Rennaafi/espeak-hub/bench/figures/fig4_latency_breakdown.pdf

0.0 | 0.5 | 1.0 | 1.5 | 2.0 | 2.5 | 3.0 | 3.5
Time from end of speech to first sound (s)

V1 (P = 250 ms)

V0

1.87 s

3.03 s

STT | LLM | TTS | device: download + start
