Rennaafi/espeak-hub/docs/images/UI 2.jpeg

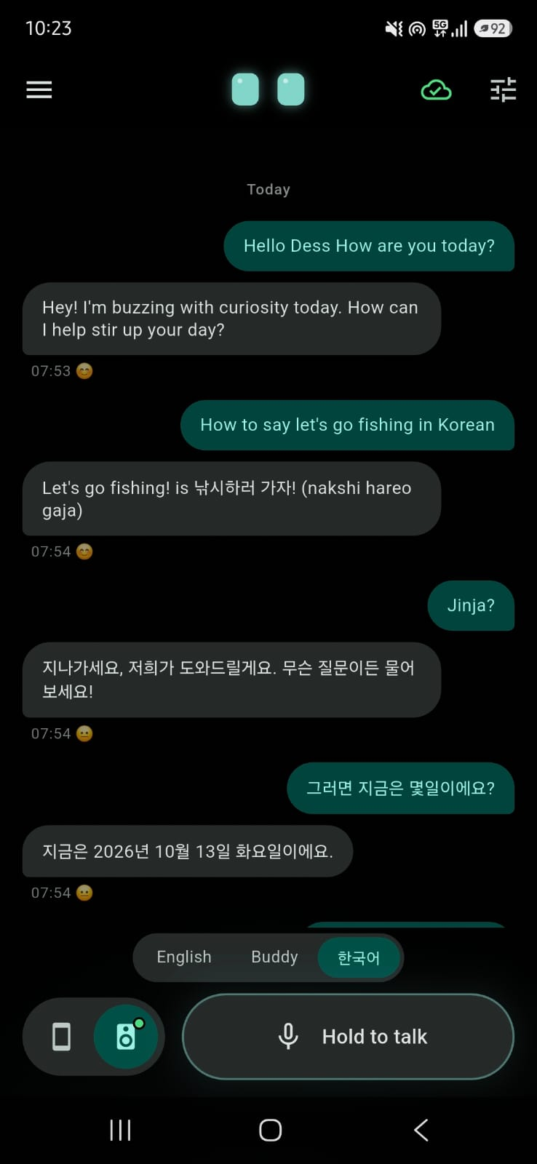
docs/images/UI 2.jpeg
