Rennaafi/espeak-hub/bench/results/summary.csv

variant | prebuf_ms | clip | n | ttfs_median | ttfs_iqr | ttfs_p95 | ttfs_max | dl_median | throughput_kBps | starves | runs_with_starve | max_gap_ms | dry | load0_median | load1_median | pload0_median | pload1_median | face_fps | face_max_gap_ms | hwm_audio_min | hwm_face_min | hwm_loop_min | hwm_i2s_min | heap_min | rssi_median
V0 |  | long | 20 | 4402.85 | 170.64 | 6357.45 | 8625.46 | 4373.33 | 146.63 | 0 | 0 | 0.00 | 0 | 10.90 | 81.10 | 6.80 | 100.00 | 20.03 | 63.26 | 1788 | 6288 | 3852 | 18444 | 196388 | -35.00
V0 |  | medium | 20 | 1306.76 | 217.44 | 1723.22 | 2076.81 | 1276.76 | 150.38 | 0 | 0 | 0.00 | 0 | 10.45 | 83.50 | 6.90 | 100.00 | 17.85 | 63.71 | 1788 | 6288 | 3852 | 18444 | 196388 | -35.50
V0 |  | short | 20 | 669.26 | 95.34 | 1299.38 | 1325.61 | 639.59 | 156.09 | 0 | 0 | 0.00 | 0 | 10.25 | 83.90 | 7.10 | 100.00 | 17.26 | 64.06 | 1788 | 6288 | 3852 | 18444 | 196388 | -35.50
V1 | 0 | long | 19 | 30.76 | 0.70 | 140.58 | 144.90 | 4267.60 | 150.27 | 0 | 0 | 0.00 | 2 | 11.60 | 91.80 | 11.60 | 91.80 | 16.89 | 65.01 | 1772 | 6256 | 3868 | 18452 | 193404 | -36.00
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
