Rennaafi/espeak-hub/bench/figures/fig3_load_face.pdf

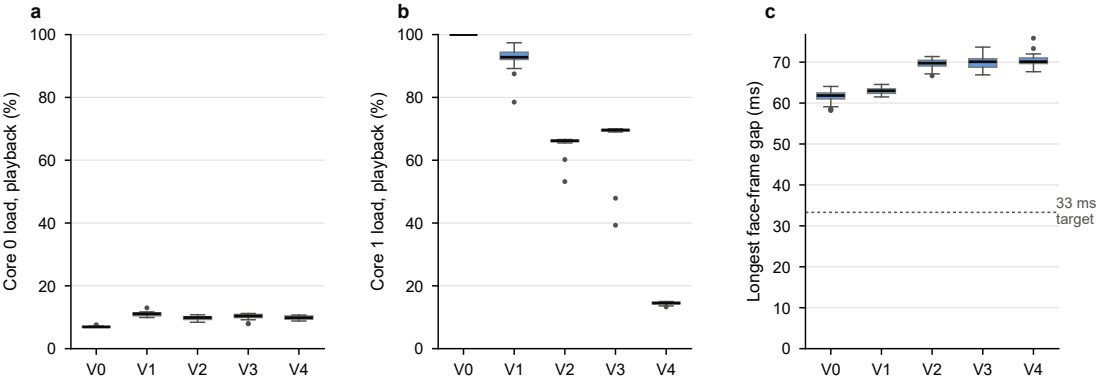
[picture p9: page 1]
33 ms target

Longest face-frame gap (ms)

Core 0 load, playback (%)

Core 1 load, playback (%)
