Rennaafi/espeak-hub/bench/figures/fig1_ttfs_v0_v1.pdf

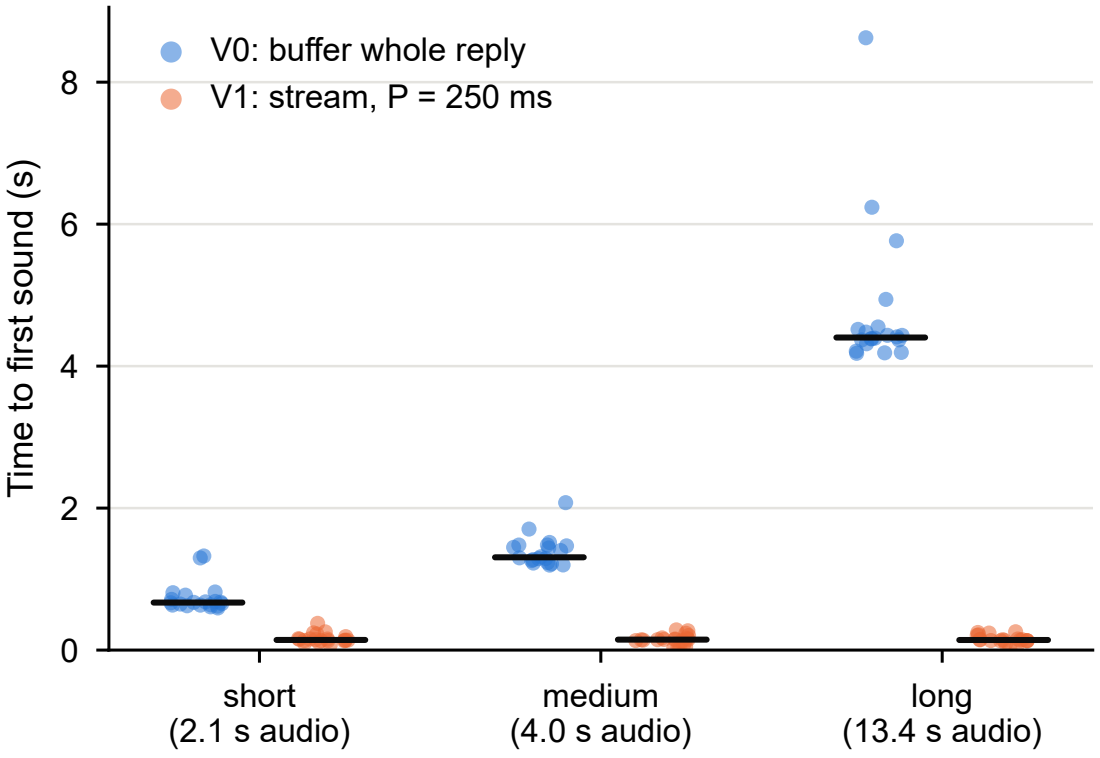
[picture p10: page 1]
short (2.1 s audio); medium (4.0 s audio); long (13.4 s audio)

V0: buffer whole reply
V1: stream, P = 250 ms

Time to first sound (s)
