Rennaafi/espeak-hub/bench/figures/fig2_prebuffer_sweep.pdf

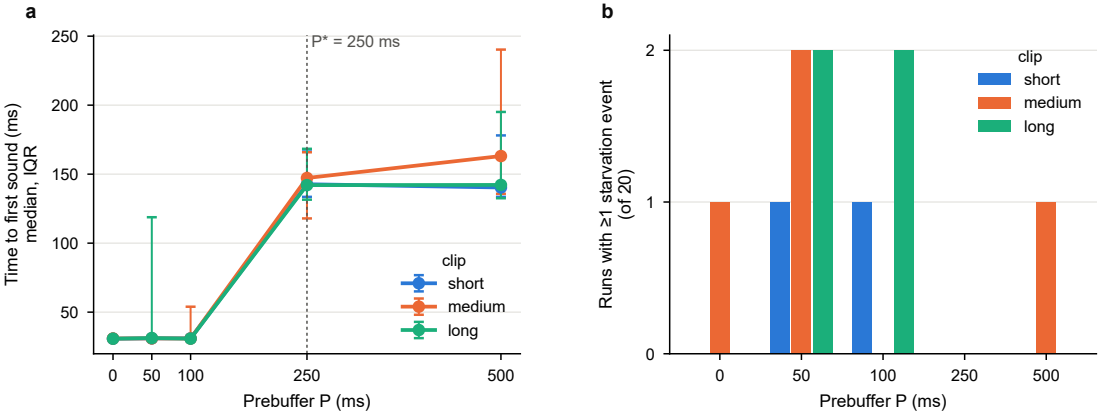
[picture p11: page 1]
Prebuffer P (ms); median, IQR; clip short medium long

Runs with ≥1 starvation event

Time to first sound (ms)
